gokeeper/hss-0130/manufacturing/plan.md

**按目前只有 5～10 套、模型尚未完成实物装配验证的条件，优先考虑：2 mm 钢制面板激光切割，工业级韧性树脂打印外壳，薄钢板底板加内部支架。先完成一套原尺寸样机，再加工余下数量。** 现有 CAD 通过了几何检查，但尚未验证真实零件装配、布线和操作载荷，直接投入模具容易增加返工费用。:chatgpt-content-reference{index="0"}

如果最终确定制作 **10 套，而且更看重外观一致性和浇注材料的选择**，可以把聚氨酯（PU）真空复模作为第二个重点询价方案。复模有母模和模具费用，在这个数量下不一定比逐件打印便宜。

**以下均为人民币预算估算，尚未取得淘宝商家针对这份 STEP 的正式报价。** 按中国大陆加工、普通外观处理估算，不含摇杆、按钮、主控板、装配人工、运输、进口费用及额外 CAD 修改；税费需要商家单独确认。公开加工平台的工艺能力与起价用于判断数量级，不能替代这只 738 mm 外壳的实际报价。

## 一、金属面板：直接激光切割，无须专用模具

现有面板是 **632 × 129 × 2 mm 的平板**。此前补齐的“弧度”属于俯视轮廓，包括圆角和斜边，**不需要把钢板压成三维曲面**。直接使用 DXF 切割外轮廓和孔即可。:chatgpt-content-reference{index="1"}:chatgpt-content-reference{index="2"}

激光切割、折弯、压铆及表面处理都是可单独外包的钣金工序。嘉立创（JLC）公开的钣金服务支持一件起做，因此这里没有必要支付冲压模具费用。:chatgpt-content-reference{index="3"}

下表为 **5～10 件同批加工的单件预算**：

| 面板方案 | 单件预算 | 适用判断 |
|---|---:|---|
| **2 mm 冷轧钢板，激光切割、去毛刺、防锈及普通喷粉** | **80～160 元** | 优先选择，厚度与现有 CAD 一致 |
| 2 mm 不锈钢，激光切割、去毛刺、普通拉丝 | 100～200 元 | 可以不喷漆，但贴装饰面膜后，拉丝外观价值有限 |
| 2.5～3 mm 铝板，切割、去毛刺、普通表面处理 | 120～250 元 | 减重备选，需要重新核对面板凹槽和按钮卡扣 |

这些费用不含彩色装饰面膜，也不含另外制作摇杆支架。

**建议保留 2 mm 钢板。** 换用铝板时，应重新检查刚度及安装条件，不能只把材料名称替换掉。现有模型的面板厚度和落位台阶深度都为 2 mm，改厚度必须同步修改。:chatgpt-content-reference{index="4"}

此外，下单前必须确定摇杆孔距版本。包内同时存在原文件的 **50 × 73 mm** 和替代版的 **40 × 85 mm**，加工厂应只收到最终选定的一份制造图。:chatgpt-content-reference{index="5"}

## 二、下壳有哪些工艺，分别需要多少钱

按接近现有外形的 **738 × 230 × 70 mm 外壳**估算，保留白色可见表面，外观要求为普通消费品样件水平。下表只计算下壳，不包括金属面板、底板、内部金属支架和电子零件。

**“摊销后单壳预算”已经包含一次性费用分摊，不要再把模具费加一遍。**

| 工艺 | 一次性母模、模具或准备费 | 做 5 个，摊销后每壳 | 做 10 个，摊销后每壳 |
|---|---:|---:|---:|
| **熔融沉积成型（FDM），分段打印、拼接、打磨喷漆** | 0～500 元 | **350～900 元** | **350～850 元** |
| **立体光固化（SLA），韧性树脂打印、打磨喷漆** | 通常无专用模具费 | **600～1,200 元** | **600～1,200 元** |
| **PU 真空复模，硅胶模具、普通喷漆** | **2,500～5,000 元** | **950～1,850 元** | **700～1,350 元** |
| **玻璃钢，模具手工铺层、修边和外观处理** | 2,000～4,500 元 | 750～1,550 元 | 550～1,100 元 |
| **ABS 厚片吸塑，成型后切边、加工开口** | 2,000～5,000 元 | 600～1,450 元 | 400～950 元 |
| **ABS 板料数控加工（CNC），含普通外观处理** | 500～1,500 元 | 1,000～2,100 元 | 950～1,950 元 |

这些是用于筛选工艺的预算范围。**吸塑和玻璃钢需要明显调整内部结构，不能把当前 STEP 原样交付，就按表中低价得到同样的全部细节。**

### 1. SLA：现阶段最值得先询价

SLA 无须制作专用模具，适合仍可能调整尺寸和结构的小批量零件。公开制造指南也把免模具、低准备成本列为打印工艺用于小批量生产的主要条件。:chatgpt-content-reference{index="6"}

价格不宜按照“小型打印盒子”理解。读取 v2 包内的实体体积记录，**仅外壳就约有 1.49 升材料体积**。按树脂密度暂取 1.1～1.2 g/cm³ 计算，约为 **1.6～1.8 kg**，这是本模型的用料估算。嘉立创公布的最低宣传起价为 **0.2 元/克**，仅按这一最低费率计算就已超过 300 元，尚未计入具体韧性材料、支撑、尺寸条件和喷漆。:chatgpt-content-reference{index="7"}

询价时，需要明确两点：

- **738 mm 外壳是否一体打印。** 分件粘接也可以报价，但必须单列，不能与一体件混在一起比较。
- **提供树脂牌号和材料数据。** “韧性树脂”“类 ABS”只是描述，不足以确认性能。例如嘉立创 LEDO 6060 的公开热变形温度为 56℃，并注明不适宜高温和强日照环境，使用条件仍有边界。:chatgpt-content-reference{index="8"}

对室内使用的这只控制器，可以把金属支架作为主要承力结构，再对打印壳做装配和反复操作验证。不能仅凭打印件外观良好就认定耐久性合格。

### 2. PU 真空复模：适合设计确定后的 10 套，但不保证更便宜

工艺通常是先制作并精修母模，再制作硅胶模具，把液态材料浇注成型。这里的“类 ABS”通常指具有相近目标性能的 **PU 浇注材料**，需要与真正的 ABS 热塑性材料区分。择幂科技（Xometry）的复模资料明确列出聚氨酯及其不同性能配方。:chatgpt-content-reference{index="9"}

上表采用的估算拆分为：

**母模及模具 2,500～5,000 元，后续每壳 450～850 元。**

一个假设报价可以说明数量的影响：打印喷漆为 900 元/壳；复模准备费为 3,500 元、后续每壳 600 元。做 5 个时，复模平均 1,300 元/壳；做 10 个时，平均 950 元/壳。**在这个报价例子中，10 件仍未比直接打印便宜。**

所以选择复模，应同时考虑材料、外观一致性和后续是否追加，不能只依据“小批量适用”作决定。

### 3. FDM、玻璃钢和吸塑：各有用途，但需要接受不同的结构条件

**FDM 是控制预算的备选。** 738 mm 外壳可以设计成若干段打印后连接，但现有 CAD 尚未设计整壳分块和承力拼接。要报价完整成品，就必须把接头设计、内部连接、填缝和喷漆算进去，不能只询问打印重量价格。:chatgpt-content-reference{index="10"}

**玻璃钢更适合把白色外壳与内部承力件分开设计。** 模具铺层、修边、喷漆及装配都属于相关外壳制造商提供的加工环节；对本项目，建议让内部金属支架承担面板安装，再由外壳提供外部形状。表中报价需以这种结构调整为前提。:chatgpt-content-reference{index="11"}

**ABS 厚片吸塑值得作为后续方案询价。** 它将加热后的塑料板贴合模具，成型后切边、加工开口，适合相对简单的薄壁形状。当前模型的实心螺柱、厚顶框和复杂内部承托，不能照搬成一件吸塑件，需要另加安装框和连接件。:chatgpt-content-reference{index="12"}

注塑则暂时排在最后。这个尺寸的专用模具，可以先按 **数万元，约 3万～10万元以上的准备费量级**理解，具体取决于结构、模具材料和加工要求，这也是预算判断。注塑的高模具投入更容易在大批量中摊薄，5～10 件不适合承担这笔费用。:chatgpt-content-reference{index="13"}

## 三、现有 CAD 在正式生产前，需要调整哪些地方

### 壁厚和顶框需要按选定工艺重新设计

v2 的 **5 mm 壁厚、10 mm 顶框、4.5 mm 底板**属于前期设计值，尚未针对某种加工工艺优化。:chatgpt-content-reference{index="14"}

例如嘉立创的复模建议壁厚为 **1～4 mm**。因此选复模时，可让加工厂评审是否改成约 3～4 mm 的主体壁厚，在安装点局部加厚或加筋，不能直接把整个顶框统一减薄。:chatgpt-content-reference{index="15"}

### 底板改用薄金属板，重新设计支架和螺柱

建议比较 **1.2～1.5 mm 折弯钢底板**，或约 **2 mm 铝底板**。这些是待验证的设计起点，具体厚度需要结合折边和支撑跨度确定。

不要把现有 4.5 mm 塑料底板直接按同样厚度加工成钢板。底板材料改变后，螺钉长度、安装台阶、电路板支柱和连接方式都需要同步修改。

承力结构建议安排为：**摇杆固定到金属面板，面板通过内部支架连接底板；外壳承担外观和部分支撑。** 现有模型在两个后排按钮附近，局部承托边仅约 **1.856 mm**，尤其需要在实物上检查，不能当作已经验证的承力结构。:chatgpt-content-reference{index="16"}

### 长尺寸配合需要单独约定，不能套用通用公差

嘉立创公布的复模精度，对 100 mm 以上尺寸为 **±0.4%**。按约 632 mm 的面板开口尺度计算，相当于约 **±2.5 mm**；现有模型只有 **单边 0.8 mm** 的名义间隙。:chatgpt-content-reference{index="17"}:chatgpt-content-reference{index="18"}

这并不表示成品一定偏差 2.5 mm，但说明仅接受通用公差不足以保证装配。需要让厂家明确：关键开口如何保证，是否要成型后精加工，或是否采用独立金属安装框定位。

### 螺纹连接要适合材料

频繁拆装的位置优先采用金属螺母、嵌件或金属支架。SLA 热固性树脂中的嵌件可以采用胶接或预留螺母座，不能直接照搬热塑性打印件的烙铁热熔安装方法。:chatgpt-content-reference{index="19"}

## 四、整套机械部分的预算

在上述下壳之外，每套再暂留：

| 项目 | 单套预算 |
|---|---:|
| 2 mm 钢面板，含普通防锈与表面处理 | 80～160 元 |
| 薄金属底板、简单承力支架及加工 | 120～250 元 |
| 普通装饰面膜、紧固件和脚垫 | 60～140 元 |
| **合计，不含下壳** | **260～550 元** |

由此得到三条路线的整批预算，已计入上表中相应的一次性费用，并作适当取整：

| 路线 | 5 套机械部分 | 10 套机械部分 |
|---|---:|---:|
| **韧性 SLA 外壳＋金属面板、底板和支架** | **约 4,500～9,000 元** | **约 9,000～18,000 元** |
| **PU 复模外壳＋相同金属件** | **约 6,100～12,000 元** | **约 9,600～19,000 元** |
| **分段 FDM 外壳＋相同金属件** | **约 3,100～7,300 元** | **约 6,100～14,000 元** |

以上未计额外返工样件。首套完成后，如果修改结构导致重新打样，需要另外增加费用。

**当前最适合先实施的是 SLA 路线。** 它避免先支付专用模具费，便于修正尚未验证的壳体和安装位置。复模应在首套装配通过后，再用同一份最终图纸比较 10 件总价。FDM 则适合愿意接受拼接结构、或自行承担部分打磨喷漆工作的情况。

## 五、在淘宝怎样找加工方和询价

优先找“手板加工”和“钣金加工”两类店铺，分别报价。搜索词可直接使用：

| 要找的供应商 | 搜索词 |
|---|---|
| 金属面板、底板 | **钣金激光切割 2mm冷轧板 DXF 小批量 喷粉** |
| 打印外壳 | **大尺寸工业SLA 韧性树脂 手板 喷油 一体打印** |
| 复模外壳 | **真空复模 PU类ABS 硅胶模具 大尺寸 小批量** |
| 替代外壳工艺 | **玻璃钢外壳 小批量开模**；**ABS厚片吸塑 外壳打样** |

给外壳加工厂的询价要求可以写成：

> 外壳最大尺寸 738×230×70 mm，分别报价 1 件样件、5 件和 10 件。附件为原尺寸 STEP，请只报价外壳，面板和底板另行加工。  
>   
> 请分别提供韧性 SLA 打印和 PU 类 ABS 真空复模方案，列明材料牌号、是否整件成型、打磨喷漆费用、关键开口精度及必要的二次加工费用。复模请分列母模、硅胶模具和后续单件价格。  
>   
> 需要白色普通半哑光表面。首件装配确认后再制作余下数量，未经确认不得自行分件粘接。请注明税费、运费，以及尺寸不合格时的返工方式。

询价附件应使用 **原尺寸外壳 STEP**，另附面板配合尺寸图。不要发送 200 mm 缩小模型，也不要把用于外观验证的 `visual_solid` 实心模型当作工作外壳，后者没有真实内部空腔。
