gokeeper/hss-0130/HSS0130_CAD_v2/README_中文.md

# HSS-0130 CAD v2

面板依据本次上传 DXF 重建；外壳宽深沿用 v1 基准，壳高、外侧曲面及部分安装位置仍为估算。新增内部安装结构属于本次设计，不是原厂结构复原。单位均为毫米。

## 1. 文件选择

| 用途 | 文件 |
|---|---|
| 原尺寸三件装配 CAD，保留上传文件全部孔位 | `full_size/HSS0130_v2_assembly_1to1.step` |
| 200 mm 宽三件装配 CAD | `scale_200mm/HSS0130_v2_assembly_200mm.step` |
| 首次打印，观察整体外形 | `scale_200mm/HSS0130_v2_visual_solid_200mm.stl` |
| 分别打印缩小外壳、底板、面板 | `scale_200mm/HSS0130_v2_three_parts_layout_200mm.3mf` |
| 用真实面板检查落位、边缘和六孔 | `fit_test_1to1/panel_fit_tile_01_1to1.stl` 至 `04` |
| 三和平安装板 JLF 孔距替代装配 | 两个尺寸目录内的 `HSS0130_v2_assembly_JLF_alternative_*.step` |

完整装配 STEP 含三个独立实体：外壳、底板、面板。各零件也有独立 STEP/STL。STEP 保留装配坐标；STL 已分别平移到打印平台，外壳翻转为顶框朝下。STL 的坐标不能直接用来替代 STEP 做装配对齐。

完整包还包括原始 DXF、反馈文件、孔位 CSV、参考 DXF、参数、构建脚本和两份数值检查结果。没有打包输入仓库的 `.git`、旧版压缩包或字体文件。

## 2. 两种比例

| 项目 | 原尺寸 | 同比例缩小版 |
|---|---:|---:|
| 外壳宽 × 深 × 高 | 738 × 230 × 70 | 200 × 62.3306 × 18.9702 |
| 面板宽 × 深 | 632 × 129 | 171.2737 × 34.9593 |
| 面板厚度，本版设计值 | 2 | 0.5420 |
| 比例 | 1 | 200/738，27.100271% |

小版来自完整几何的统一缩放，孔径、壁厚和配合间隙也按同一比例缩小，没有局部增厚或放大。导入切片软件后用 **100% 比例、毫米单位**。不要再缩到 27.1%。

三件式 3MF 的排列包络约 200 × 173.561 × 18.970 mm。平台可用面积需大于此尺寸，并另留裙边、支撑和平台夹具空间。200 mm 宽外形版适用于有足够可用范围的约 220 × 220 mm 平台；较小的平台需统一调整比例或重新生成。

### 打印用途与限制

外形验证版 `visual_solid` 是一个封闭的一体模型。面板接缝和孔位用浅凹表示，内部没有工作外壳的空腔。它适合先检查轮廓、前缘形状和面板位置；切片时可设低填充，CAD 封闭实体不要求 100% 填充。

三件式缩小版保留真实空腔和小孔，面板只有约 0.54 mm 厚，部分孔隙很小。它适合观察结构比例，不能据此测试真实螺钉、按钮或摇杆安装。打印前检查切片预览中的薄壁、小孔和支撑；尚未实际切片试打验证。3MF 只含通用几何和排列，没有绑定打印机、材料或切片参数。

原尺寸外壳长 738 mm，不能在普通家用打印平台一次成型。本包没有将整只工作外壳分块或设计承力拼接。原尺寸面板默认厚 2 mm，是可修改的材料厚度假定；不能据此认为同厚度打印塑料能承受摇杆操作力。

## 3. 面板与外壳的主要修正

面板由上传 `Sega Layout 2L16B - FrancoB + Sega P1-P2.dxf` 的制造图层直接导入。前缘采用 350 mm 直线中段、两侧斜线、前角 R30 和后角 R5，保留圆弧实体。没有用照片描边或用一条弧线替代。

凹槽按该轮廓向外等距偏移 0.8 mm，最大尺寸 633.6 × 130.6 mm。面板厚度参数控制凹槽深度，默认均为 2 mm，装配后上表面齐平。

承托边以向内 5 mm 偏移为基础，再避让按钮和摇杆空间。靠近后缘的按钮使承托边局部缩窄，不能把它理解为全周恒定 5 mm。最靠后两个 P2 按钮附近的直线边，按本版避让尺寸计算，剩余承托宽度约 1.856 mm。这是几何余量，不是强度结论。

保留 16 个 Ø30 操作按钮孔、2 个 Ø24 开始按钮孔、2 个 Ø24 摇杆轴孔、8 个 Ø4.5 摇杆安装孔、6 个 4.6 × 4.6 方孔。孔位使用 DXF 全精度值，不使用反馈表中四舍五入后的坐标。

六个方孔下增加承托柱、通孔和螺母座；参数以 M4 尺寸等级为设计初值，原装螺钉型号未确认。底板增加八组连接柱和连筋，但其中心坐标仍沿用 v1 照片估算。后壁增加 Ø10 出线孔，底板增加可关闭、可修改的四柱 PCB 安装区。未设计具体 USB 插座、线夹、橡胶护圈或应力释放结构。

## 4. 上传文件的 JLF 孔距需要单独处理

源 DXF 每只摇杆的四孔中心间距为 **X=50、Y=73 mm**。三和电子（Sanwa Denshi）2020–2021 目录中，JLF-TP-8YT-SK 平安装板标为 **85 × 40 mm**；长边朝面板前后方向安装时对应 **X=40、Y=85 mm**。两套孔距不同。[1，印刷页5]

因此提供两种面板，名称明确区分：

- `panel_source_DXF`：完整保留上传 DXF，不擅自更改实物面板的孔位。默认装配使用这一版。它与所引用的三和平安装板孔距不匹配，可能需要确认现有支架或另做转接。
- `panel_JLF_40x85_alternative`：只替换八个 Ø4.5 摇杆安装孔，其余外轮廓、按钮孔和六个方孔不变。两个尺寸均提供替代装配 STEP；另有 `reference/panel_ALTERNATIVE_JLF_40x85_panel_coordinates.dxf`，仍使用原面板坐标。

使用替代版前仍须核对手头的摇杆型号、安装板、连接器朝向和紧固件。不能把所有 JLF 型号与安装板视为同一种安装界面。CAD 不包含实体摇杆、按钮、接插件或螺钉。

## 5. 下方空间与参数

面板底面 Z=68，底板上表面 Z=4.5，控制器区域名义净高 **63.5 mm**。扣除本版自定的 50 mm 安装及布线预留，尚余 13.5 mm。

制造商目录中，裸 JLF 尺寸图给出 34 mm 的机体尺寸基准；OBSF-30 和 OBSF-24 的图中，面板法兰下方至端子端部约为 31.7 和 32 mm。[1，印刷页4、13] 裸体尺寸不能直接代表安装板、插头及弯线完成后的总深度，因此 50 mm 明确标为本次设计预留，不冒充厂家数据。

每个摇杆采用 80 × 110 mm 的全高避让矩形，每个按钮采用 Ø40 mm 的全高避让区，实际切削再加 0.3 mm 余量。较大的摇杆区用于容纳机体、安装板和连接器方向的不确定性。相邻避让包络局部重叠属于保守包络相交，不等于实际零件互相穿透，也不代表已完成零件之间的装配验证。

三和 OBSF 目录给出的最大安装板厚为 3.9 mm。[1，印刷页13] 增加 `panel_thickness` 时，要重新考虑所选按钮的卡扣条件。底板 PCB 安装孔距默认为 58 × 28 mm，仅是可修改布局，不对应任何已核实的编码板。

## 6. 原尺寸配合试片

`fit_test_1to1` 内有完整配合环，尺寸约 **645.6 × 142.6 × 10 mm**，以及四个原尺寸分片，每片 **161.4 × 142.6 × 10 mm**。分片各自为单个封闭实体，两个中间片增加了低于面板落位面的薄连接条，避免前后两条承托边成为独立零件。

四片都按 100% 打印，按编号 01 至 04 从玩家视角的左向右排列。平直后边靠同一直尺，在平整底板上对齐拼缝并固定，核对总宽 645.6 mm，再放入真实面板检查局部轮廓、落位和六个固定孔。分片没有精密定位键，打印收缩、拼缝和对齐误差会影响总孔距；不能仅凭拼接后能放入就认定全尺寸加工公差已合格。

此试片只截取上部 10 mm，不包含完整承托柱高度、摇杆、布线或整壳受力路径；不能用于操作摇杆或承载测试。中间连接条也不是最终外壳的一部分。

## 7. 坐标和可复现构建

v2 使用右手坐标系：X 正方向为玩家右侧；Y 正方向远离玩家；后侧基准 Y=0，前缘为负 Y；Z 向上。P1 位于负 X，未镜像左右按钮。

源 DXF 只平移到 CAD：X=x_panel−316，Y=y_panel−194.8。反馈表中的“朝玩家为正 Y”对应本版 Y 的相反数。孔位 CSV 同时保留源坐标、CAD 坐标和反馈坐标。

使用可运行 Python 环境安装 `source/requirements.txt` 内依赖后，在解压目录执行：

```bash
python source/build_hss0130_v2.py --params source/parameters.json
python source/check_exports.py
```

生成另一个宽度时，例如可用平台较小：

```bash
python source/build_hss0130_v2.py --params source/parameters.json --small-width 160 --out ./rebuilt_160mm
```

生成器只读取本包 `input/panel_source_2L16B.dxf`，不依赖原脚本引用但未随包提供的其他模板文件。修改设计前另存参数与输出目录。STEP 是边界表示实体；参数化重建通过 Python/CadQuery 源码进行，不包含某商业 CAD 的原生特征树。

`source/render_preview.py` 为可选预览脚本，需要额外的 VTK、Pillow 和无头显示环境；模型重建不依赖它。

## 8. 检查结论与剩余限制

`validation_report.json` 保存七项几何检查，包含面板间隙、开口覆盖、避让区、六个安装点、净高、外包络和零件相交。`export_roundtrip_check.json` 将交付 STEP 重新导入，再检查三实体、源 DXF 对应关系、两种摇杆孔距、均匀缩放、全部 STL 和 3MF。

本版通过几何检查。面板全周采样间隙约 0.79935–0.80000 mm；这一微小波动来自计算时的曲线离散，不是制造公差。实体间重叠体积为零，源面板与重新导入 STEP 的对称差体积在数值精度下为零。

尚未进行实物打印、真实面板装配、摇杆及按钮插接、布线、静力或疲劳测试。壳体 70 mm 高度、外侧曲面、顶部标签/说明卡区、面板在壳体上的前后位置以及底板八孔仍为估算或沿用定位假设。本包不能视为 HSS-0130 原厂外壳或 CQN-1051 的可直接互换工程图。

## 资料

[1] 三和电子（Sanwa Denshi），《SANWA DENSHI GAME'S PARTS CATALOG 2020–2021》，印刷页4、5、13。制造商目录由经销商提供副本：
https://www.rs2006.co.jp/e/sanwaseimitsu/Sanwa2020.pdf

输入资料、具体参数变化和文件核对见 `修改与核对报告_中文.md`。
