gokeeper/hss-0130/HSS0130_CAD_v2/修改与核对报告_中文.md

# HSS-0130 第二版修改与核对记录

## 输入检查

检查了上传 `hss-0130.tar` 中的最终 DXF、反馈文档、两张预览/叠加图、面板构建脚本，以及嵌套的旧版 CAD 压缩包中的参数与源代码。仓库 `.git` 元数据不参与几何建模，也未复制到输出。没有执行输入仓库脚本；新生成器只导入最终 DXF 的指定制造图层。

| 输入 | 使用方式 |
|---|---|
| `Sega Layout 2L16B - FrancoB + Sega P1-P2.dxf` | 面板外轮廓与孔位的主依据，毫米单位，原件复制为 `input/panel_source_2L16B.dxf` |
| `HSS0130_feedback_for_case_CAD.md` | 开口、安装、空间和七项验收要求 |
| `HSS0130 case vs 2L16B panel.png` | 确认旧开口大于真实面板以及前缘形状差异 |
| `Sega Layout 2L16B - preview.png` | 孔位方向和布局的目视核对 |
| `tools/build_panel.py` | 核对组合面板、源坐标和摇杆孔的生成逻辑，不用它重造现有 DXF |
| `HSS0130_CAD_v1.zip` | 外壳延续参数、旧凹槽/开口问题、底孔估算值来源 |

源 DXF 的 SHA-256：
`e72318162d4923a58550615b52b968e3966dca6737da14b732210cda59eb845c`

本报告中的“确定”只表示来自用户提供的最终 DXF，未独立用实物量具验证其制造误差。上传资料没有给出新的外壳侧面测量或三维扫描；因此本次不会把原来估算的外侧曲面升级为实测数据。

## 一、外轮廓及孔位

DXF `$INSUNITS=4`。导入 `0`、`P1_BUTTONS_30`、`P2_BUTTONS_30`、`P1_JLF_MOUNT_HOLES`、`P2_JLF_MOUNT_HOLES`，忽略开放参考线图层。识别到一个由十条直线/圆弧边构成的外轮廓，以及三十四个内部孔轮廓。

外轮廓最大宽632、深129 mm。前缘中间从(141,0)至(491,0)，为350 mm直线；前角R30的圆心为(30,41.16879379234069)、(602,41.16879379234069)；后角R5，圆心为(5,124)、(627,124)。两侧斜线、圆弧端点均直接采用DXF全精度数据。

三十四个内部轮廓包括16个Ø30动作按钮孔、2个Ø24开始按钮孔、2个Ø24摇杆轴孔、8个Ø4.5摇杆安装孔、6个4.6方孔。主面板全部保留，不借助屏幕截图重新定位，也不使用四舍五入到0.1 mm的反馈表代替DXF。

## 二、旧值与新值

| 项目 | v1 | v2 |
|---|---|---|
| 面板 | 648.4×148.4的无孔占位板 | DXF的632×129，带全部34孔 |
| 面板前缘 | 连续浅弧 | 350直线中段、两段斜线、R30前角、R5后角 |
| 凹槽最大尺寸 | 650×150 | 633.6×130.6，DXF外偏移0.8 |
| 主通孔 | 634×134，大于真实面板 | DXF内偏移5作为基础，再做局部电子零件避让和六处承托 |
| 凹槽深/面板厚 | 5/4.5，不齐平 | 同一参数，默认2/2，上面齐平 |
| 面板六个固定点 | 未恢复 | 从六个方孔导出，逐个承托柱、通孔、方颈避让、六角螺母座 |
| 底板连接 | 八个估计孔，没有完整连接结构 | 保留估计孔位，增加连接柱、连筋和螺母座 |
| 出线与PCB | 无 | 后壁Ø10通孔，58×28可变四柱布局 |
| 缩小版 | 200mm宽 | 同为200mm宽，所有v2几何严格同步缩放 |

“634×134大于632×129”的问题已从结构上消除。新版开口边界包含局部避让，不能用一个宽深矩形完整描述，应使用`effective_opening_DESIGN_1to1.dxf`。`nominal_opening_5mm_DESIGN_1to1.dxf`只是未做避让时的基础轮廓，不能当成最终加工开口。

## 三、六个面板连接点

v2使用X向玩家右、Y向远离玩家、Z向上的右手坐标。后侧Y=0，因此整个面板Y为负。反馈文档的Y数值取相反数即可对应。

| 位置 | CAD X | CAD Y | 反馈 Y |
|---|---:|---:|---:|
| 后左 | −310 | −71.8 | 71.8 |
| 后中 | 0 | −71.8 | 71.8 |
| 后右 | 310 | −71.8 | 71.8 |
| 前左 | −310 | −156.8 | 156.8 |
| 前右 | 310 | −156.8 | 156.8 |
| 前中 | 0 | −188.5 | 188.5 |

承托柱默认R9、高16；通孔Ø4.5；上口5×5、深2的方颈避让；下端六角螺母座对边7.4、深3.4 mm。这些是可调设计值，不声称与原装M4螺栓、垫片或螺母完全一致。面板方孔仍严格4.6×4.6。紧固件和操作载荷未建模。

面板柱的螺母座从下方开放，使向下夹紧的面板螺钉可由柱内材料承受拉紧力。底板柱的螺母座从上方开放，保留底部承压台阶，配合自底面向上穿入的螺钉。仅有几何构造检查，没有承载能力结论。

## 四、三和JLF孔距冲突

上传构建脚本与最终DXF生成的是50×73 mm孔距。DXF本身没有足够信息证明这种孔距适用于用户手头的支架。

三和电子2020–2021目录印刷页5给出的平安装板型号JLF-TP-8YT-SK，安装尺寸85×40 mm。按长边前后放置，即X40、Y85。该目录页也展示不同安装板/插头朝向，不能把安装要求泛化到所有JLF产品。

本版没有用“修正JLF”的理由覆盖原文件：默认面板与默认装配保留50×73；另生成40×85的替代面板、两种比例的替代装配及单独替代DXF。替代版本只改八个摇杆小孔，仍为Ø4.5，所有按钮孔、轴孔、六个方孔和面板外形均保持。

原文件可能对应自制支架或另一个安装系统。选择版本前需对实际安装板量孔距。替代版没有对特定螺钉头做沉孔，也没有设计摇杆转接板。

## 五、零件空间、局部承托与净高

摇杆避让由反馈提出的约60×95扩大为80×110 mm，两个方向都保留余量，覆盖厂商图示机体及连接器朝向的不确定性。按钮避让Ø40。切削另外加入0.3 mm，均贯穿底板上方至面板下方的整个内部高度。内部加强筋、连接柱及PCB柱与这些区域作实体相交检查。

最靠后的P2按钮中心距面板后缘22.156 mm，Ø40避让加0.3边距后，直线后缘的剩余承托约1.856 mm。两颗按钮附近采用局部削窄，其他位置仍按5 mm基础承托，并在六个固定点局部加宽。面板承托接触面积约7662.8 mm²，只表示几何接触面积，不能据此推断材料的承载能力。

扩大避让后，两小段附加加强筋成为独立碎块。生成器先证明它们完全位于附加加强筋原始材料内，再删除这两块，保留整壳单一实体。未通过任意“只取最大实体”的方法掩盖其他脱离的安装结构；若有非加强筋的独立结构会直接报错。

面板底面68，底板上面4.5，控制区域净高63.5 mm。厂商裸JLF图示34 mm、OBSF-30/24法兰以下约31.7/32 mm。设计同时为摇杆/按钮设50 mm安装深度要求，包括对插头和线缆的预留，名义余量13.5 mm。50 mm为设计参数，仍须依据实际接插件和弯线方式检查。

## 六、保留估算的部分

外壳738×230沿用旧版引用的产品包络。壳高70、前缘鼓出20、外壳平面前角R30/后角R12、上缘R6/下缘R1.5、壁厚5、顶框厚10、底板厚4.5等仍为估算或设计值。

面板后缘距离壳体后侧65.8 mm延续反馈采用的定位假设。DXF确定的是面板自身形状和孔位，不会自动确定它在原装塑料壳内的真实前后位置。

底板八个固定孔中心仍为v1照片估算，未从这次面板文件推出新的精度。顶部标签/说明卡浅槽仍为占位。新增内部螺柱、筋条、出线、PCB安装区为本次独立设计。原厂筋位、锁扣、铰链、投币相关结构和CQN-1051机柜安装界面没有恢复。

## 七、几何验证与交付检查

`validation_report.json`记录反馈要求的七项检查。有效开口由整块原始外壳截面减去最终外壳截面求得，没有预先裁剪到面板范围，避免“无未覆盖区”成为自证的检查。结果显示有效开口超出面板外轮廓的面积为零。

全周1200点的间隙检查约0.79935–0.80000 mm，对照0.8±0.05的几何要求通过；圆弧采样导致约0.00065的数值差，不属于实物公差。所有六个方孔下方都有对齐的通孔和承托环；全部控制器全高避让区与壳体及底板重叠体积为零；三个零件的两两重叠体积为零。

`export_roundtrip_check.json`独立重新读取交付STEP：两种尺寸各为三个有效实体；与DXF重新挤出的源面板做双向差集验证；实际圆柱面提取的摇杆小孔距分别为50×73和40×85；两种STEP的体积比按同一线性缩放系数的立方一致。全部15份STL重新读取后均闭合、法向一致、体积为正。

3MF为三个网格，排版包络200×173.561×18.970 mm。四片原尺寸配合试片各161.4×142.6×10 mm，均为一个闭合实体。拼接环没有精密定位键，需在平面夹具上对齐并核对总长。

几何检查通过与“原文件JLF孔距匹配”是两个不同事项。报告将后者明确保留为false。没有将几何通过描述成全部硬件装配通过。

## 外部资料

三和电子（Sanwa Denshi），《SANWA DENSHI GAME'S PARTS CATALOG 2020–2021》，印刷页4、5、13；PDF页面索引2、3、11。资料为制造商目录、经销商托管副本。
https://www.rs2006.co.jp/e/sanwaseimitsu/Sanwa2020.pdf

尚未进行实物打印、实际切片配置验证、面板装配、布线或强度测试。尺寸和孔位核实后，工作外壳仍需结合材料、层向、紧固件和摇杆操作载荷进一步验证。
