gokeeper/hss-0130/HSS0130_CAD_v2/input/source_panel_preview.png

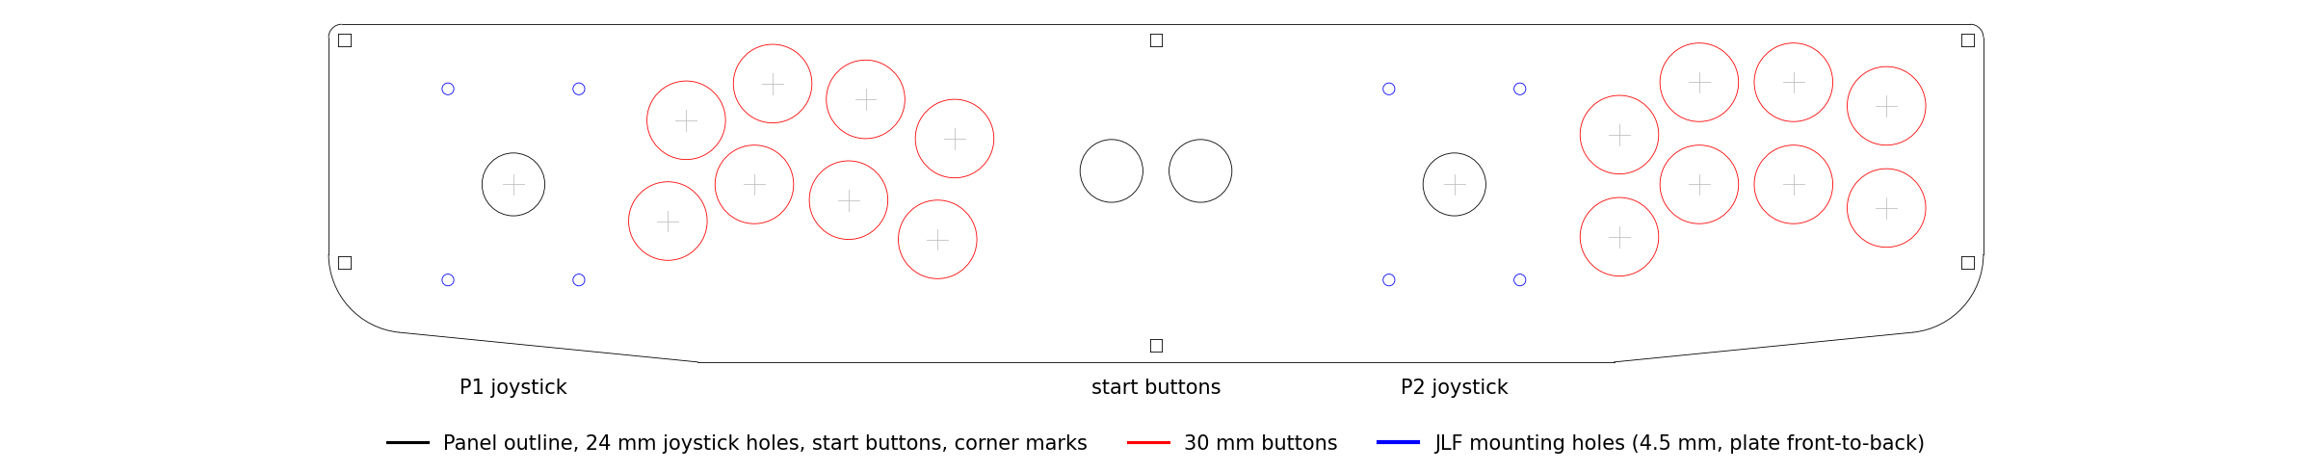
HSS0130_CAD_v2/input/source_panel_preview.png
