gokeeper/hss-0130/HSS0130_CAD_v2/input/v1_fit_overlay.png

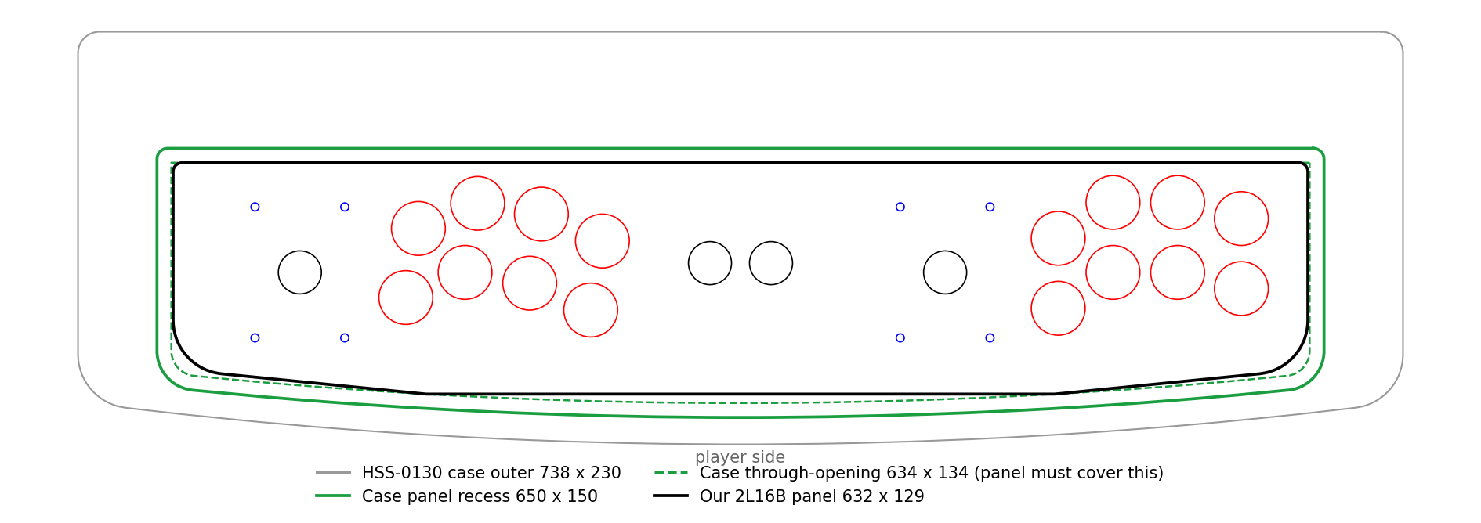
HSS0130_CAD_v2/input/v1_fit_overlay.png
