gokeeper/hss-0130/HSS0130_CAD_v2/preview/HSS0130_CAD_v2_preview.png

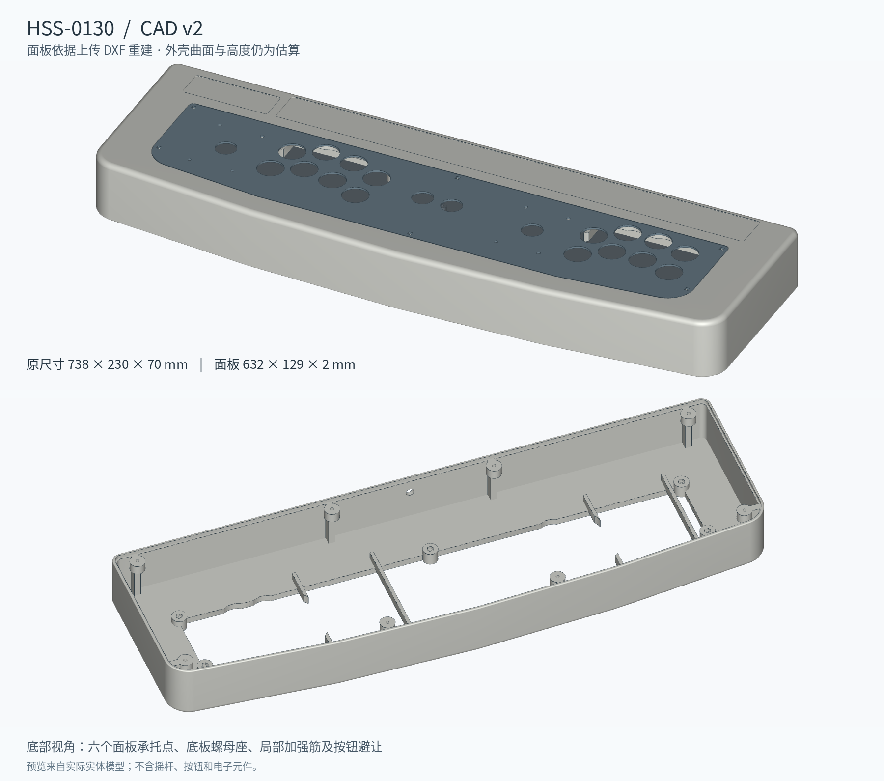
HSS0130_CAD_v2/preview/HSS0130_CAD_v2_preview.png
