gokeeper/hss-0130/HSS0130_CAD_v2/input/panel_source_2L16B.dxf

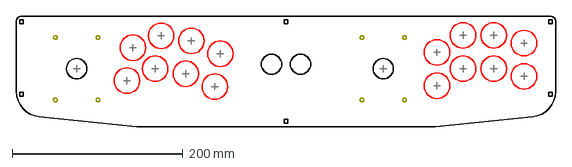
[picture p10: CAD file, 2026-09-26]
HSS0130_CAD_v2/input/panel_source_2L16B.dxf
632.0 x 129.0 mm
