gokeeper/hss-0130/HSS0130_CAD_v2/reference/electronics_keepouts_NOT_PRINT_PART.step

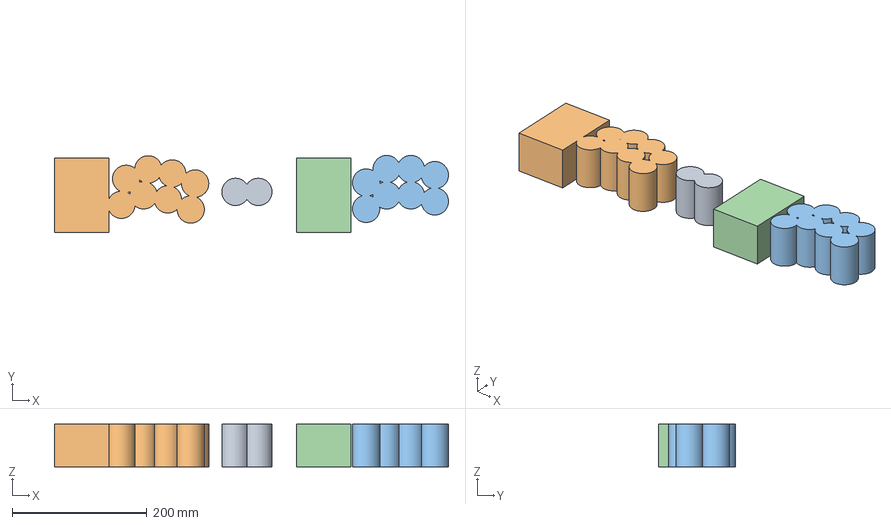
[picture p11: CAD file, 2026-09-27]
HSS0130_CAD_v2/reference/electronics_keepouts_NOT_PRINT_PART.step
585.0 x 114.6 x 63.5 mm
