gokeeper/hss-0130/HSS0130_CAD_v2/scale_200mm/HSS0130_v2_panel_JLF_40x85_alternative_200mm.step

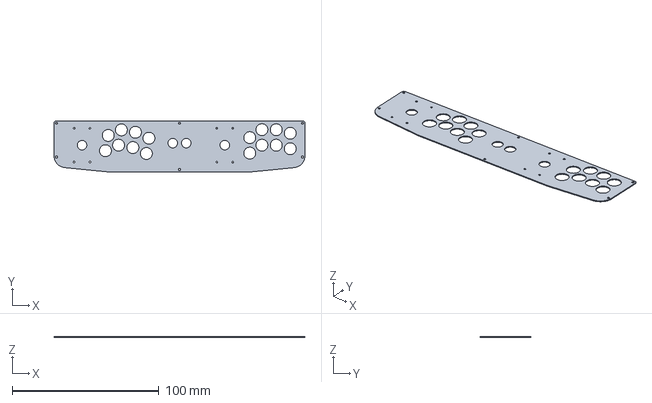
[picture p12: CAD file, 2026-09-27]
HSS0130_CAD_v2/scale_200mm/HSS0130_v2_panel_JLF_40x85_alternative_200mm.step
171.3 x 35.0 x 0.542 mm
