gokeeper/hss-0130/HSS0130_CAD_v2/reference/panel_recess_DESIGN_1to1.dxf

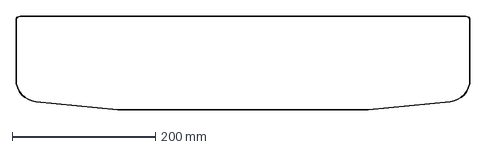
[picture p15: CAD file, 2026-09-27]
HSS0130_CAD_v2/reference/panel_recess_DESIGN_1to1.dxf
633.6 x 130.6 mm
