gokeeper/hss-0130/HSS0130_CAD_v2/fit_test_1to1/panel_fit_tile_03_1to1.step

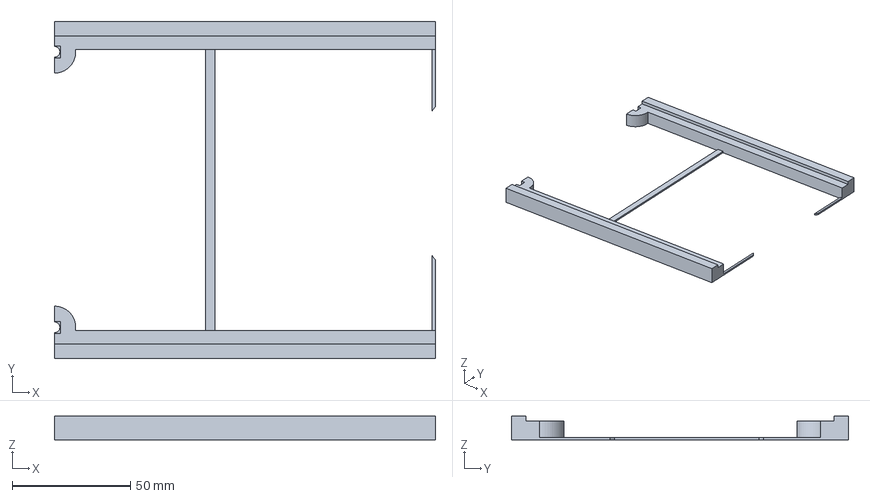
[picture p16: CAD file, 2026-09-27]
HSS0130_CAD_v2/fit_test_1to1/panel_fit_tile_03_1to1.step
161.4 x 142.6 x 10.0 mm
