gokeeper/hss-0130/HSS0130_CAD_v2/reference/panel_source_outline_EXACT_1to1.dxf

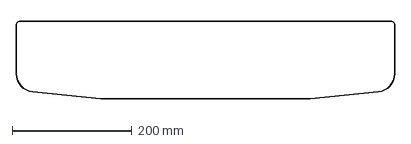
[picture p17: CAD file, 2026-09-27]
HSS0130_CAD_v2/reference/panel_source_outline_EXACT_1to1.dxf
632.0 x 129.0 mm
