gokeeper/hss-0130/HSS0130_CAD_v2/full_size/HSS0130_v2_panel_JLF_40x85_alternative_1to1.step

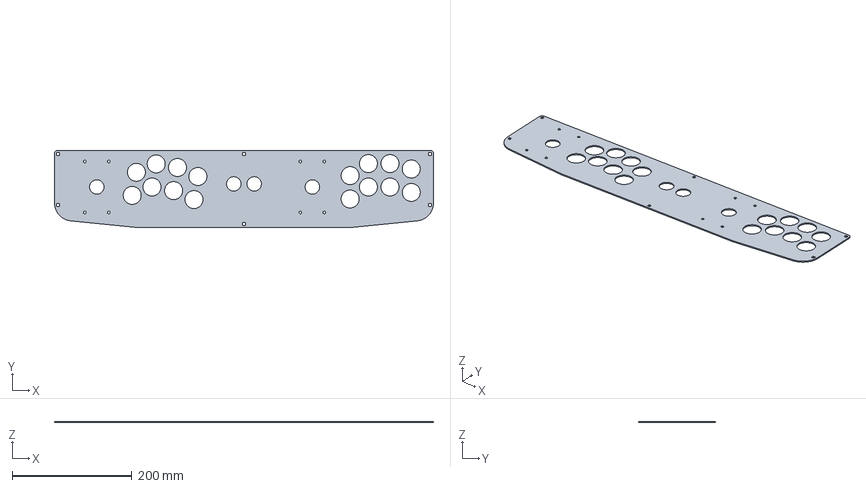
[picture p19: CAD file, 2026-09-27]
HSS0130_CAD_v2/full_size/HSS0130_v2_panel_JLF_40x85_alternative_1to1.step
632.0 x 129.0 x 2.00 mm
