gokeeper/hss-0130/HSS0130_CAD_v2/reference/outer_ESTIMATE_1to1.dxf

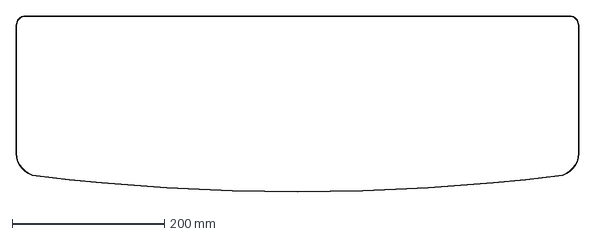
[picture p20: CAD file, 2026-09-27]
HSS0130_CAD_v2/reference/outer_ESTIMATE_1to1.dxf
738.0 x 236.8 mm
