gokeeper/hss-0130/HSS0130_CAD_v2/reference/panel_ALTERNATIVE_JLF_40x85_panel_coordinates.dxf

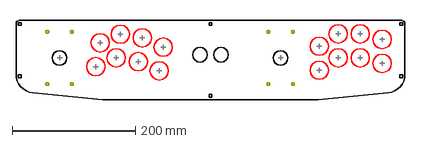
[picture p23: CAD file, 2026-09-27]
HSS0130_CAD_v2/reference/panel_ALTERNATIVE_JLF_40x85_panel_coordinates.dxf
632.0 x 129.0 mm
