gokeeper/hss-0130/HSS0130_CAD_v2/scale_200mm/HSS0130_v2_bottom_200mm.step

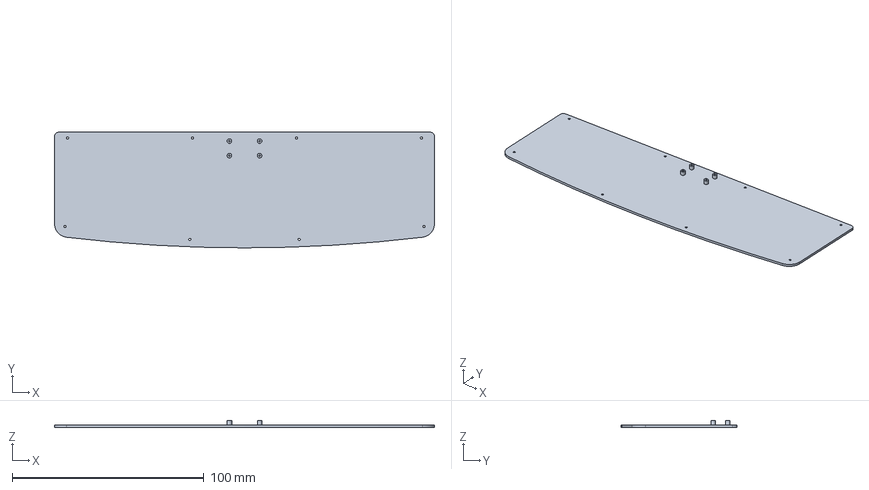
[picture p24: CAD file, 2026-09-27]
HSS0130_CAD_v2/scale_200mm/HSS0130_v2_bottom_200mm.step
197.9 x 60.3 x 3.39 mm
