gokeeper/hss-0130/HSS0130_CAD_v2/full_size/HSS0130_v2_shell_1to1.step

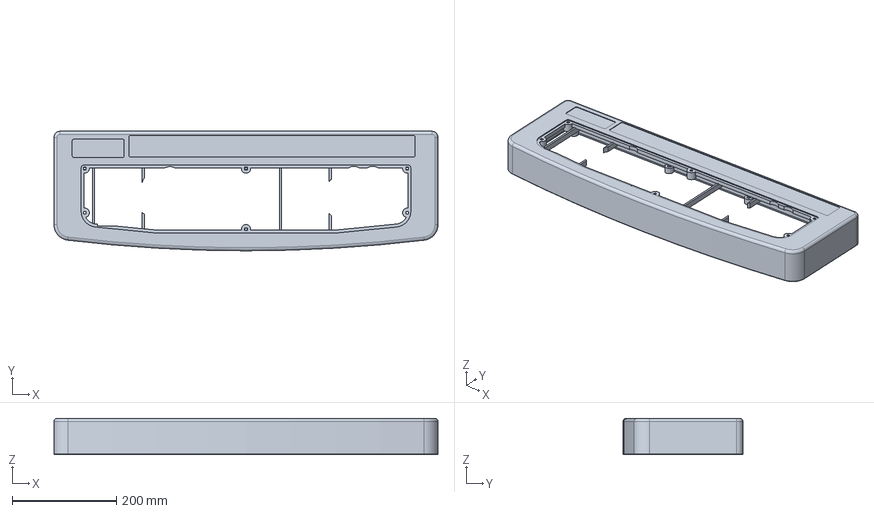
[picture p25: CAD file, 2026-09-27]
HSS0130_CAD_v2/full_size/HSS0130_v2_shell_1to1.step
738.0 x 230.0 x 70.0 mm
