gokeeper/hss-0130/HSS0130_CAD_v2/reference/bottom_outline_ESTIMATE_1to1.dxf

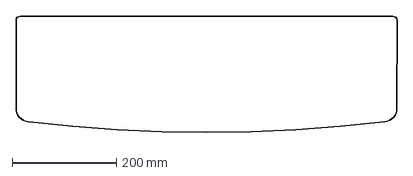
[picture p26: CAD file, 2026-09-27]
HSS0130_CAD_v2/reference/bottom_outline_ESTIMATE_1to1.dxf
730.4 x 229.2 mm
