gokeeper/hss-0130/HSS0130_CAD_v2/scale_200mm/HSS0130_v2_shell_200mm.step

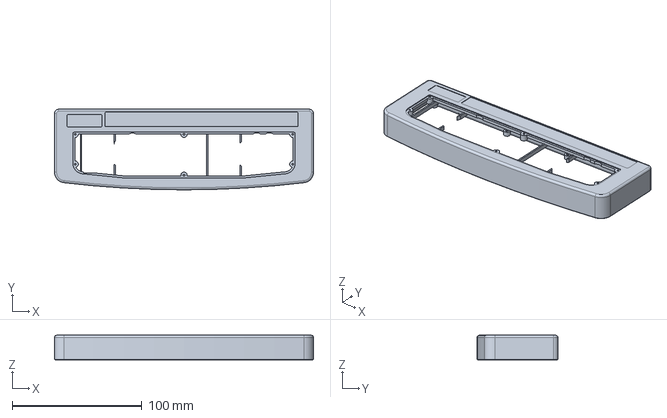
[picture p27: CAD file, 2026-09-27]
HSS0130_CAD_v2/scale_200mm/HSS0130_v2_shell_200mm.step
200.0 x 62.3 x 19.0 mm
