gokeeper/hss-0130/HSS0130_CAD_v2/full_size/HSS0130_v2_bottom_1to1.step

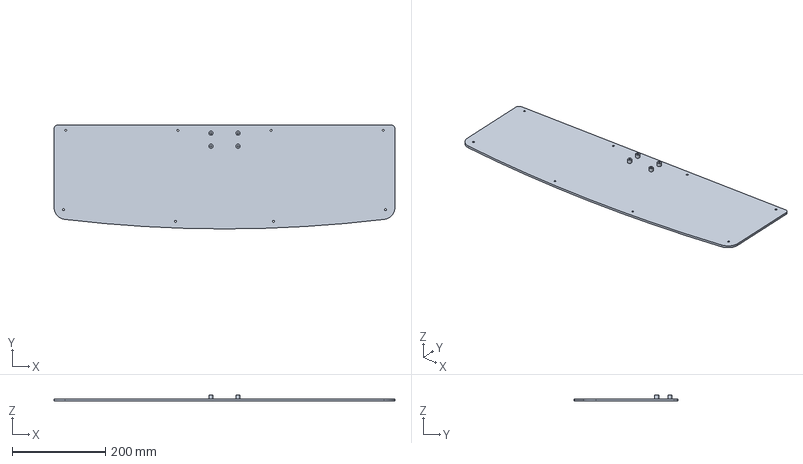
[picture p28: CAD file, 2026-09-27]
HSS0130_CAD_v2/full_size/HSS0130_v2_bottom_1to1.step
730.4 x 222.4 x 12.5 mm
