gokeeper/hss-0130/HSS0130_CAD_v2/reference/nominal_opening_5mm_DESIGN_1to1.dxf

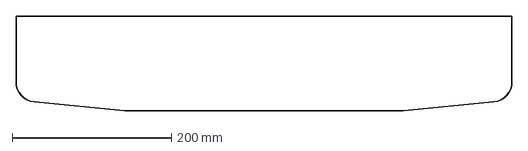
[picture p29: CAD file, 2026-09-27]
HSS0130_CAD_v2/reference/nominal_opening_5mm_DESIGN_1to1.dxf
622.0 x 119.0 mm
