gokeeper/hss-0130/HSS0130_CAD_v2/scale_200mm/HSS0130_v2_three_parts_layout_200mm.3mf

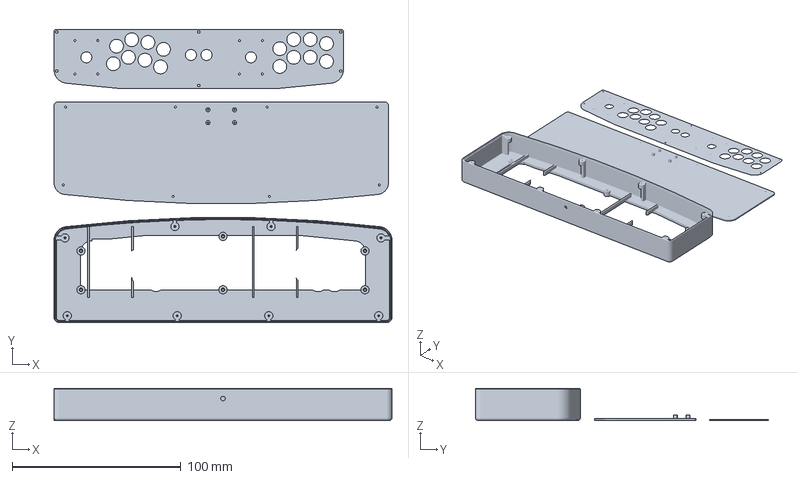
[picture p30: CAD file, 2026-09-27]
HSS0130_CAD_v2/scale_200mm/HSS0130_v2_three_parts_layout_200mm.3mf
200.0 x 173.6 x 19.0 mm
