gokeeper/hss-0130/HSS0130_CAD_v2/reference/effective_opening_DESIGN_1to1.dxf

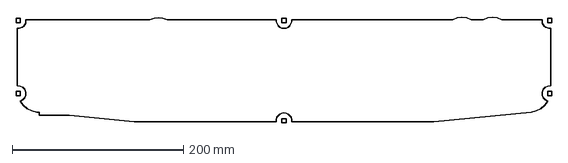
[picture p31: CAD file, 2026-09-27]
HSS0130_CAD_v2/reference/effective_opening_DESIGN_1to1.dxf
625.0 x 124.4 mm
