gokeeper/hss-0130/(list of files, cad)

Other CAD files:
HSS0130_CAD_v2/full_size/HSS0130_v2_assembly_1to1.step
HSS0130_CAD_v2/scale_200mm/HSS0130_v2_assembly_JLF_alternative_200mm.step
HSS0130_CAD_v2/scale_200mm/HSS0130_v2_panel_source_DXF_200mm.step
HSS0130_CAD_v2/full_size/HSS0130_v2_panel_source_DXF_1to1.step
HSS0130_CAD_v2/fit_test_1to1/panel_fit_ring_1to1.stl
HSS0130_CAD_v2/fit_test_1to1/panel_fit_tile_01_1to1.stl
HSS0130_CAD_v2/fit_test_1to1/panel_fit_tile_02_1to1.stl
HSS0130_CAD_v2/fit_test_1to1/panel_fit_tile_03_1to1.stl
HSS0130_CAD_v2/fit_test_1to1/panel_fit_tile_04_1to1.stl
HSS0130_CAD_v2/full_size/HSS0130_v2_bottom_1to1.stl
HSS0130_CAD_v2/full_size/HSS0130_v2_panel_JLF_40x85_alternative_1to1.stl
HSS0130_CAD_v2/full_size/HSS0130_v2_panel_source_DXF_1to1.stl
HSS0130_CAD_v2/full_size/HSS0130_v2_shell_1to1.stl
HSS0130_CAD_v2/full_size/HSS0130_v2_visual_solid_1to1.stl
HSS0130_CAD_v2/scale_200mm/HSS0130_v2_bottom_200mm.stl
HSS0130_CAD_v2/scale_200mm/HSS0130_v2_panel_JLF_40x85_alternative_200mm.stl
HSS0130_CAD_v2/scale_200mm/HSS0130_v2_panel_source_DXF_200mm.stl
HSS0130_CAD_v2/scale_200mm/HSS0130_v2_shell_200mm.stl
HSS0130_CAD_v2/scale_200mm/HSS0130_v2_visual_solid_200mm.stl
