gokeeper/hss-0130/HSS0130_CAD_v2/preview/assembly_actual.png

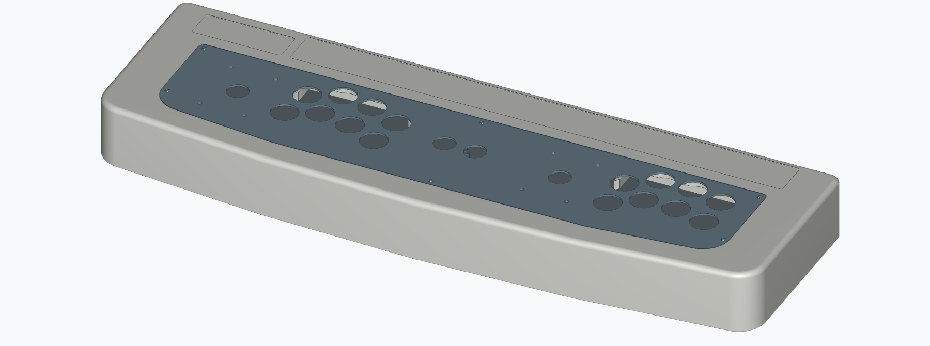
HSS0130_CAD_v2/preview/assembly_actual.png
