gokeeper/hss-0130/HSS0130_CAD_v2/fit_test_1to1/打印说明_中文.txt

HSS0130 CAD v2 原尺寸面板配合试片

01、02、03、04 四个 STL 均按 100% 比例、毫米单位打印。
每片尺寸约 161.4 × 142.6 × 10 mm；四片合计原始包络约 645.6 × 142.6 × 10 mm。

从玩家视角的左向右依次排列 01 至 04，后方直边靠同一直尺。
在平整底板上对齐拼缝、固定，核对总宽 645.6 mm，再放入真实面板。
此处验证的是原尺寸面板轮廓、落位台阶和六个方孔的局部配合。

分片采用平面对接，没有精密定位键。打印缩放、收缩、翘曲和拼缝会影响总孔距。
中间两片的低位细连接条用于让试片保持为一个打印实体，不属于最终外壳。
试片只截取外壳顶部 10 mm，不含完整安装柱，不验证摇杆/线束高度，也不能用于摇杆操作或强度测试。

完整 panel_fit_ring_1to1 文件长约 645.6 mm，供 CAD 查看或大平台制造，不能在普通家用打印机上整片打印。
