gokeeper/hss-0130/(commit log)

2026-09-26 init files
    [Sega Layout 2L16B - FrancoB + Sega P1-P2.dxf]
2026-09-27 add v2
    [HSS0130_v2_assembly_1to1.step, HSS0130_v2_assembly_200mm.step, HSS0130_v2_assembly_JLF_alternative_1to1.step, HSS0130_v2_assembly_JLF_alternative_200mm.step, HSS0130_v2_bottom_1to1.step, HSS0130_v2_bottom_1to1.stl, HSS0130_v2_bottom_200mm.step, HSS0130_v2_bottom_200mm.stl]
